jianweizou/dianjian/doc/產品圖片a.jpg

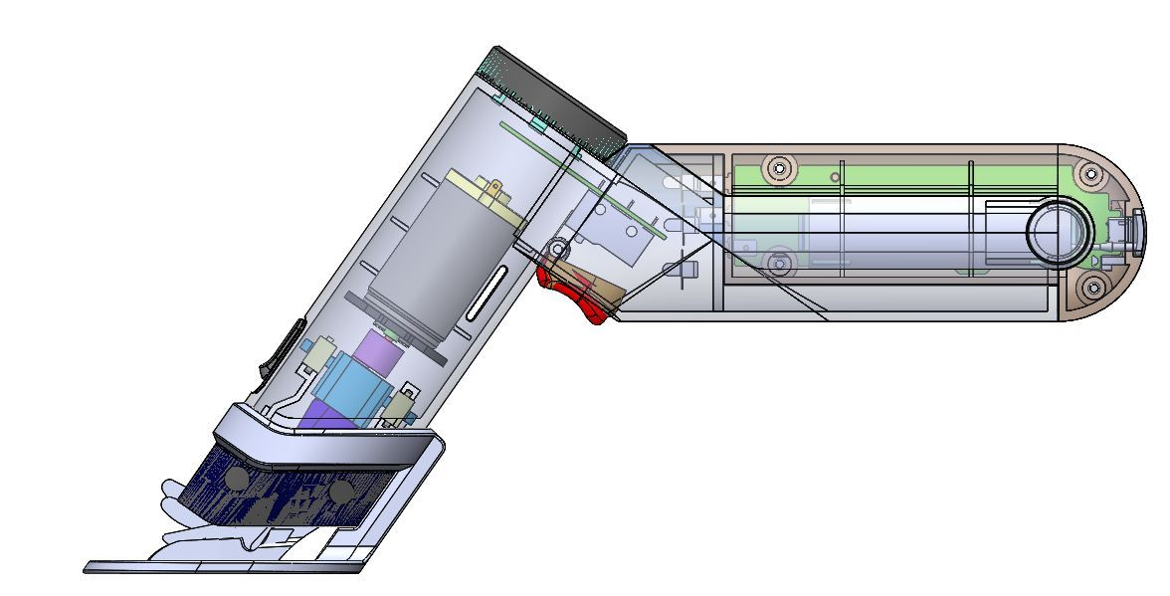
doc/產品圖片a.jpg
