jianweizou/dianjian/doc/產品圖片.jpg

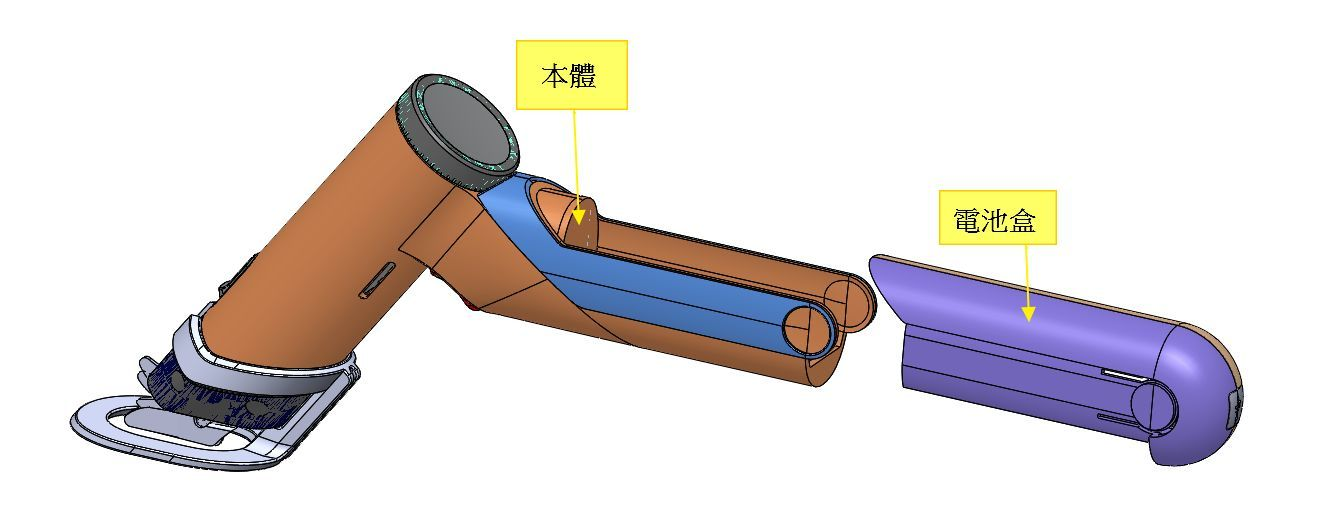
doc/產品圖片.jpg
