jianweizou/dianjian/電剪/產品規格表_Product SPEC20181105 V3.xls

專案系列碼 Project Code |  | 125 | 日期 Date | 2018-11-05 | 版次 Version | V3
專案名稱 Project Name |  | Knives |  |  | 頁次 Page | 1 of 1
機構規格 ME SPEC
項次 No. | 項目 Item |  | 客戶需求 Customer Requirement
1 | Dimensions (LxWxD) |  | mm
2 | Weight |  | g
3 | 外觀處理 |  | TBD
4 | 操作模式
 | 旋鈕 |  | 三段模式 OFF, ON, Auto
 | 按鍵 |  | 當旋鈕切為 ON, 按鍵按下為啟動 當旋鈕切為 Auto 按鍵無功能 當旋鈕切為 OFF 按鍵無功能
5 | 材質 |  | ABS ( 2.5T )
6 | 外觀處理 |  | TBD
7
電氣規格 EE SPEC
項次 No. | 項目 Item |  | 客戶需求 Customer Requirement
1 | Battery |  | 18650 x 1 3.7V 2200mAh 日本電芯
 |  |  | 電池組含充飽斷電 過充保護
2 | Charger |  | 5V Micro USB 電池包直充 無 charging stand
3 | Charging time |  | 30~60mins ( based on 1A 5V adaptor)
4 | Switch
 | 旋鈕 |  | 三段模式 OFF, ON, Auto
 | 按鍵 |  | 當旋鈕切為 ON, 按鍵按下為啟動 當旋鈕切為 Auto 按鍵無功能 當旋鈕切為 OFF 按鍵無功能
5 | Motor |  | Rated Voltage: 3.7VDC Rated Speed: 8,500rpm (min.) Rated Current: 2.0A (max.) Rated Torque: 60g-cm (min.)
5 | Fake Battery |  | no Battery, DC in jack
7 | Fake Battery Adaptor |  | 500mA 4.2V
8
必要規範 Necessary conditions
項次 No. | 項目 Item |  | 客戶需求 Customer Requirement
1 | Cerfitication |  | RoHs, GS, CE
2 | Cutting Range |  | Cotton Fabric
 |  |  | Rubber and Kevlar
 |  |  | Solid Cardboard
 |  |  | Plastic Sheets (PVC)
備註 Note
