jianweizou/dianjian/電剪/pcb板圖.JPG

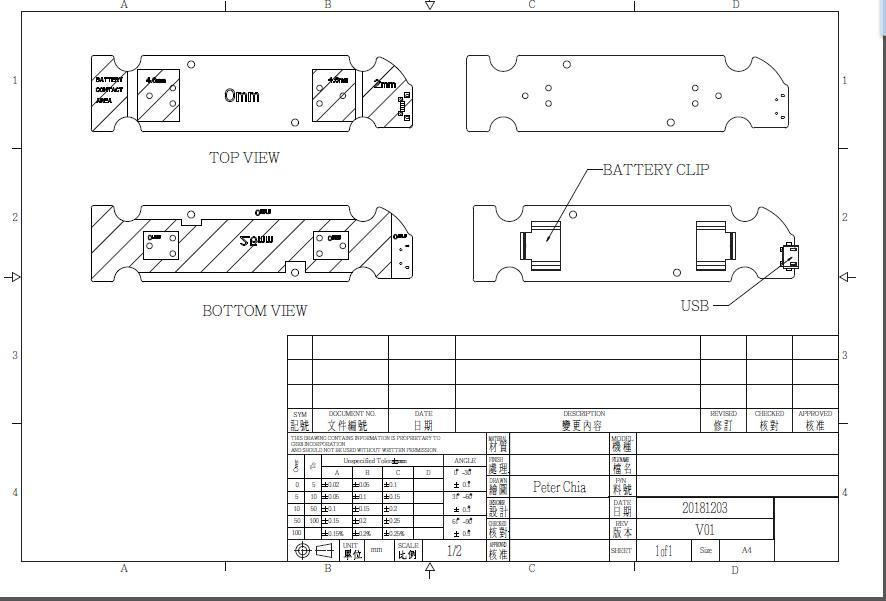
電剪/pcb板圖.JPG
