jianweizou/dianjian/電剪/無電池有線模式產品說明.JPG

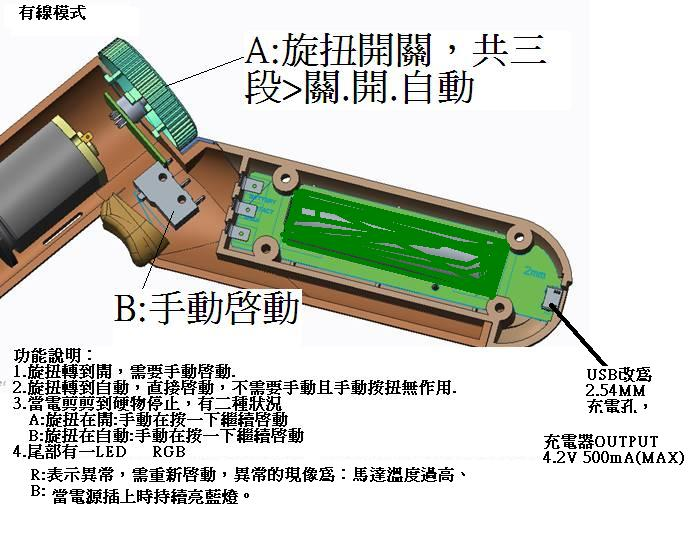
電剪/無電池有線模式產品說明.JPG
