jianweizou/dianjian/電剪/產品示意圖.jpg

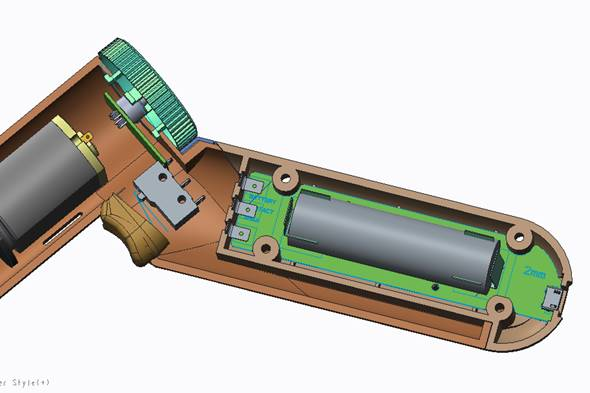
電剪/產品示意圖.jpg
