jianweizou/dianjian/電剪/電池模式產品說明.JPG

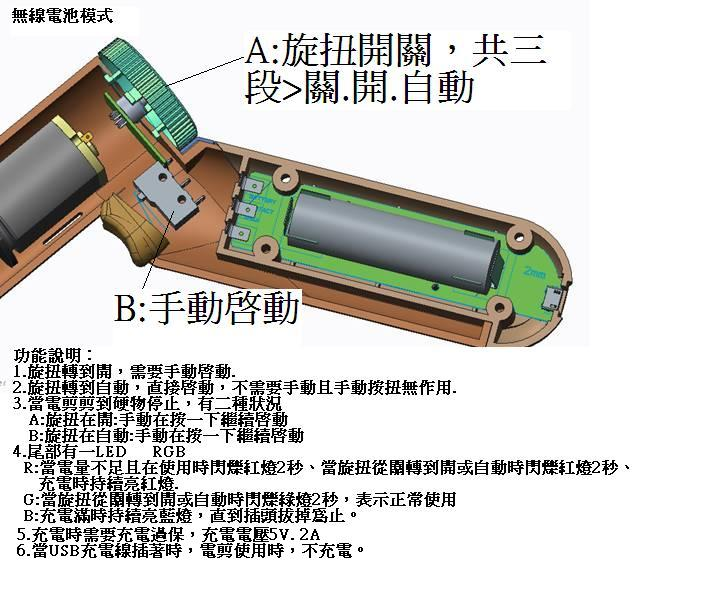
電剪/電池模式產品說明.JPG
