jianweizou/dianjian/电池版本/Layout/电剪_V1.0_20190311/电剪_V1.0.xls

电剪_V1.0
Comment | Designator | Footprint | Quantity | Name
22uF | C1, C4, C8 | C-0805 | 3 | 贴片电容
1uF | C2, C3, C5, C9 | C-0603 | 4
0.1uF | C6 | C-0603 | 1
10uF | C7, C10 | C-0805 | 2
470K | R1 | R-0603 | 1 | 贴片电阻
1M | R2, R3 | R-0603 | 2
4.7K | R4 | R-0603 | 1
1K | R5, R19 | R-0603 | 2
100R | R6 | R-0603 | 1
10K | R7, R9, R10, R16, R20 | R-0603 | 5
0.03R | R8 | R-0805 | 1 |  | https://detail.1688.com/offer/576834509003.html
1.2K | R11 | R-0603 | 1
2K | R12 | R-0603 | 1
330R | R21 | R-0603 | 1
120K | R13 | R-0603 | 1
100K | R14, R15, R17, R18 | R-0603 | 4
LED0 | D1 | LED-0603 | 1 | 贴片LED
18650 | P1 | HDR1X2 | 1 | 2.54mm单排插针180度
TDC-065D | P2 | TDC-065D | 1 | TDC-065D
Header 2 | P3 | HDR1X2 | 1 | 2.54mm单排插针180度
Molex 53398 | P4 | Molex 53398 | 1 | Molex 53398 | 参考链接：https://item.szlcsc.com/264869.html
BM2301 | Q1 | SOT-23 | 1 | MOS(场效应管)
8050 | Q2, Q3 | SOT-23 | 2 | 三极管
DW01 | U1 | SOT-23-6L | 1 | 电池保护IC
PT5110E SOT23 | U2 | SOT-23 | 1 | LDO
8205A | U3 | TSSOP-8 | 1 | IC
TP4056 SOP8 | U4 | ESOP8 | 1 | IC
LM321 | U5 | SOT-23-5 | 1 | IC
N76E003AQ20 | U6 | QFN-20 0.4mm | 1 | IC
