jianweizou/dianjian/doc/Electric Scissor_MB_2D_20190218/main_board_v2.dxf

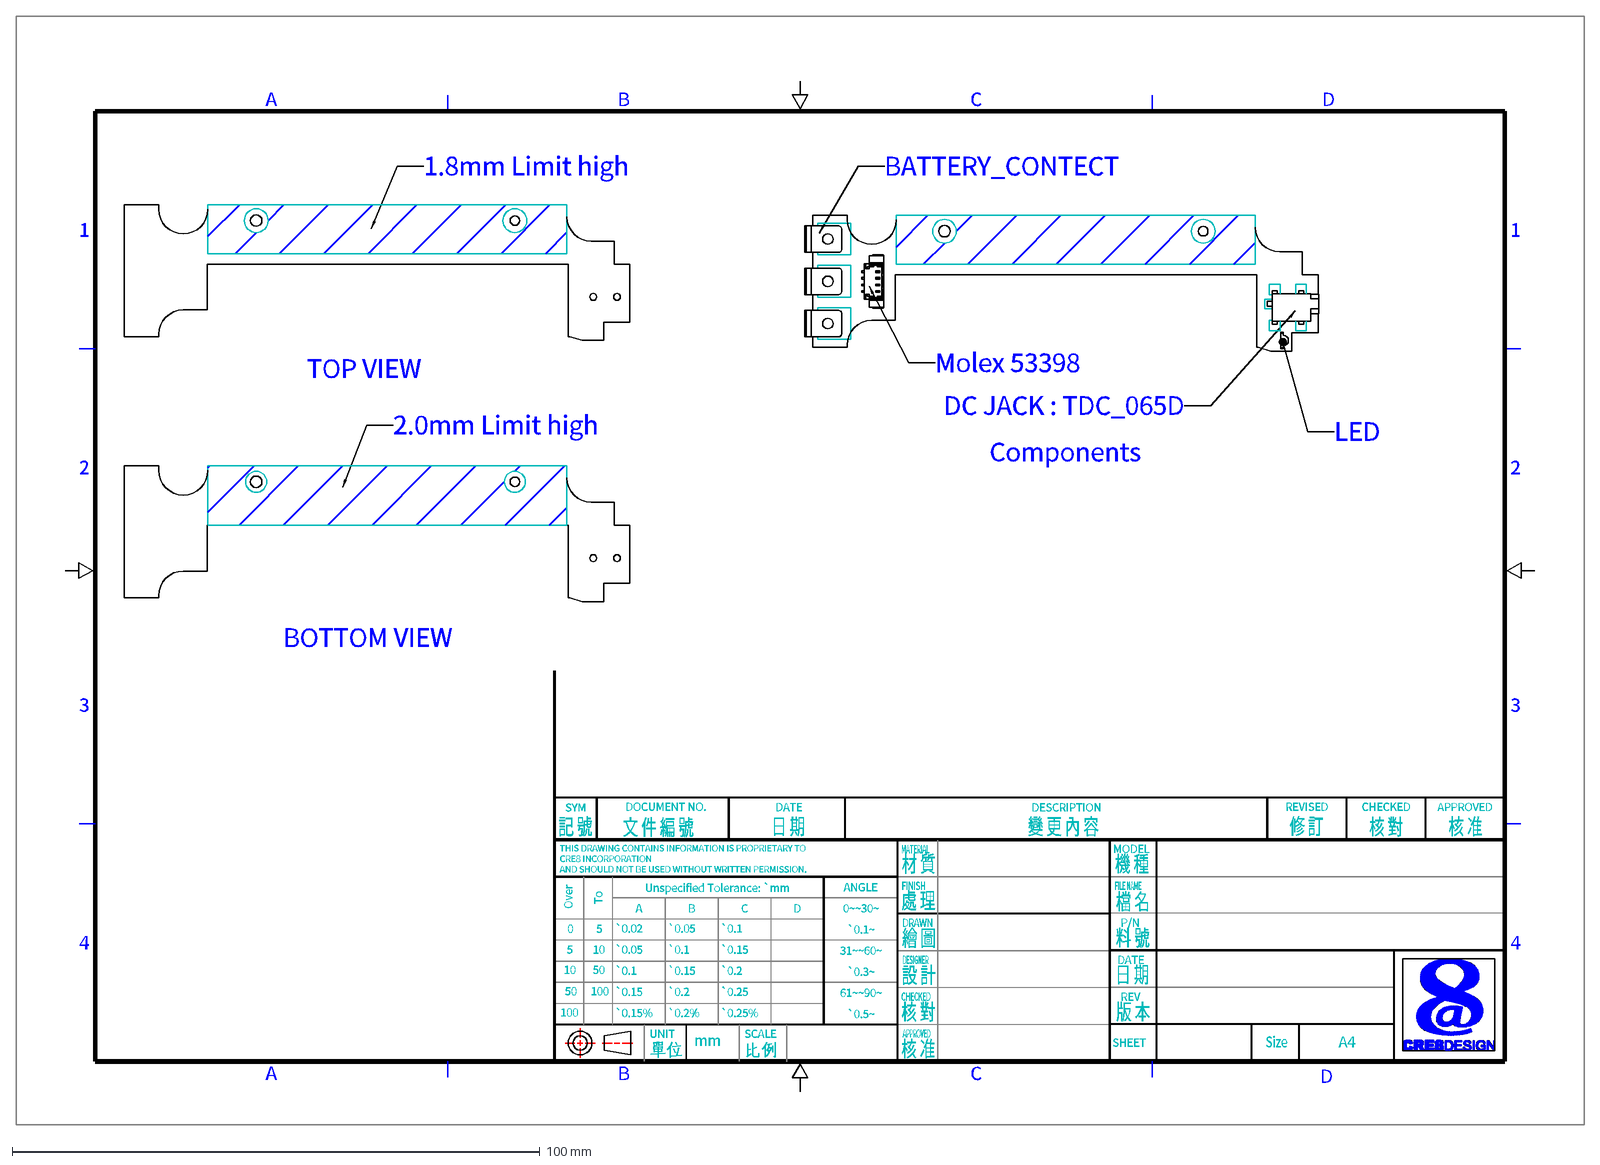
[picture p8: CAD file, 2019-02-26]
doc/Electric Scissor_MB_2D_20190218/main_board_v2.dxf
A
B
C
4
3
CRE8 INCORPORATION
10
SCALE
UNIT
mm
100
50
AND SHOULD NOT BE USED WITHOUT WRITTEN PERMISSION.
0
5
D
ANGLE
THIS DRAWING CONTAINS INFORMATION IS PROPRIETARY TO
2
1
DESCRIPTION
DATE
DOCUMENT NO.
SYM
REVISED
APPROVED
CHECKED
Over
To
A4
DESIGNER
FINISH
DRAWN
MATERIAL
FILE NAME
P/N
MODEL
REV
SHEET
機 種
檔 名
料 號
日 期
版 本
材 質
處 理
設 計
核 准
繪 圖
核 對
Size
記 號
文 件 編 號
變 更 內 容
修 訂
TOP VIEW
BOTTOM VIEW
Components
1.8mm Limit high
2.0mm Limit high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
