jianweizou/dianjian/电池版本/Layout/电剪_V1.0_20190311/电剪_V1.0.DXF

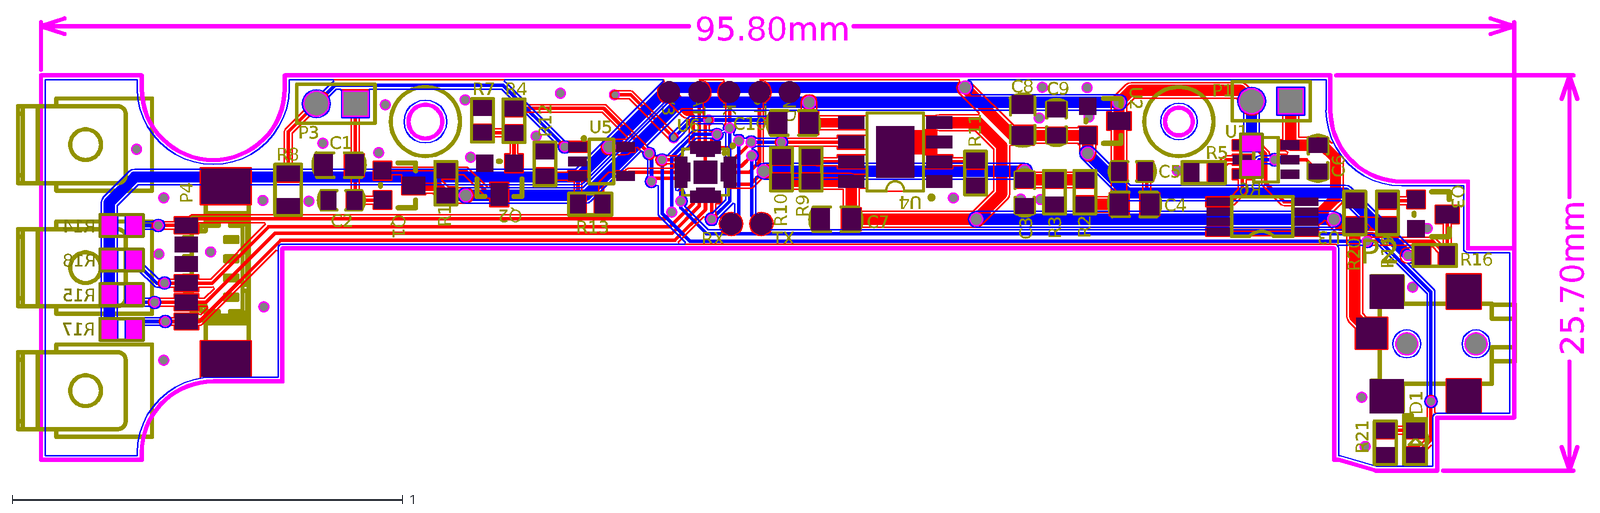
[picture p10: CAD file, 2019-03-12]
电池版本/Layout/电剪_V1.0_20190311/电剪_V1.0.DXF
TX
RX
3V3
DAT
CLK
RST
GND
95.80mm
25.70mm
P2
U6
U5
U4
U3
U2
U1
R21
R20
R19
R18
R17
R16
R15
R14
R13
R12
R11
R10
R9
R8
R7
R6
R5
R4
R3
R2
R1
Q3
Q2
Q1
P4
P3
P1
D1
C10
C9
C8
C7
C6
C5
C4
C3
C2
C1
