jianweizou/dianjian/doc/Electric Scissor_MB_2D_20190218/main_board_v2.pdf

A

1

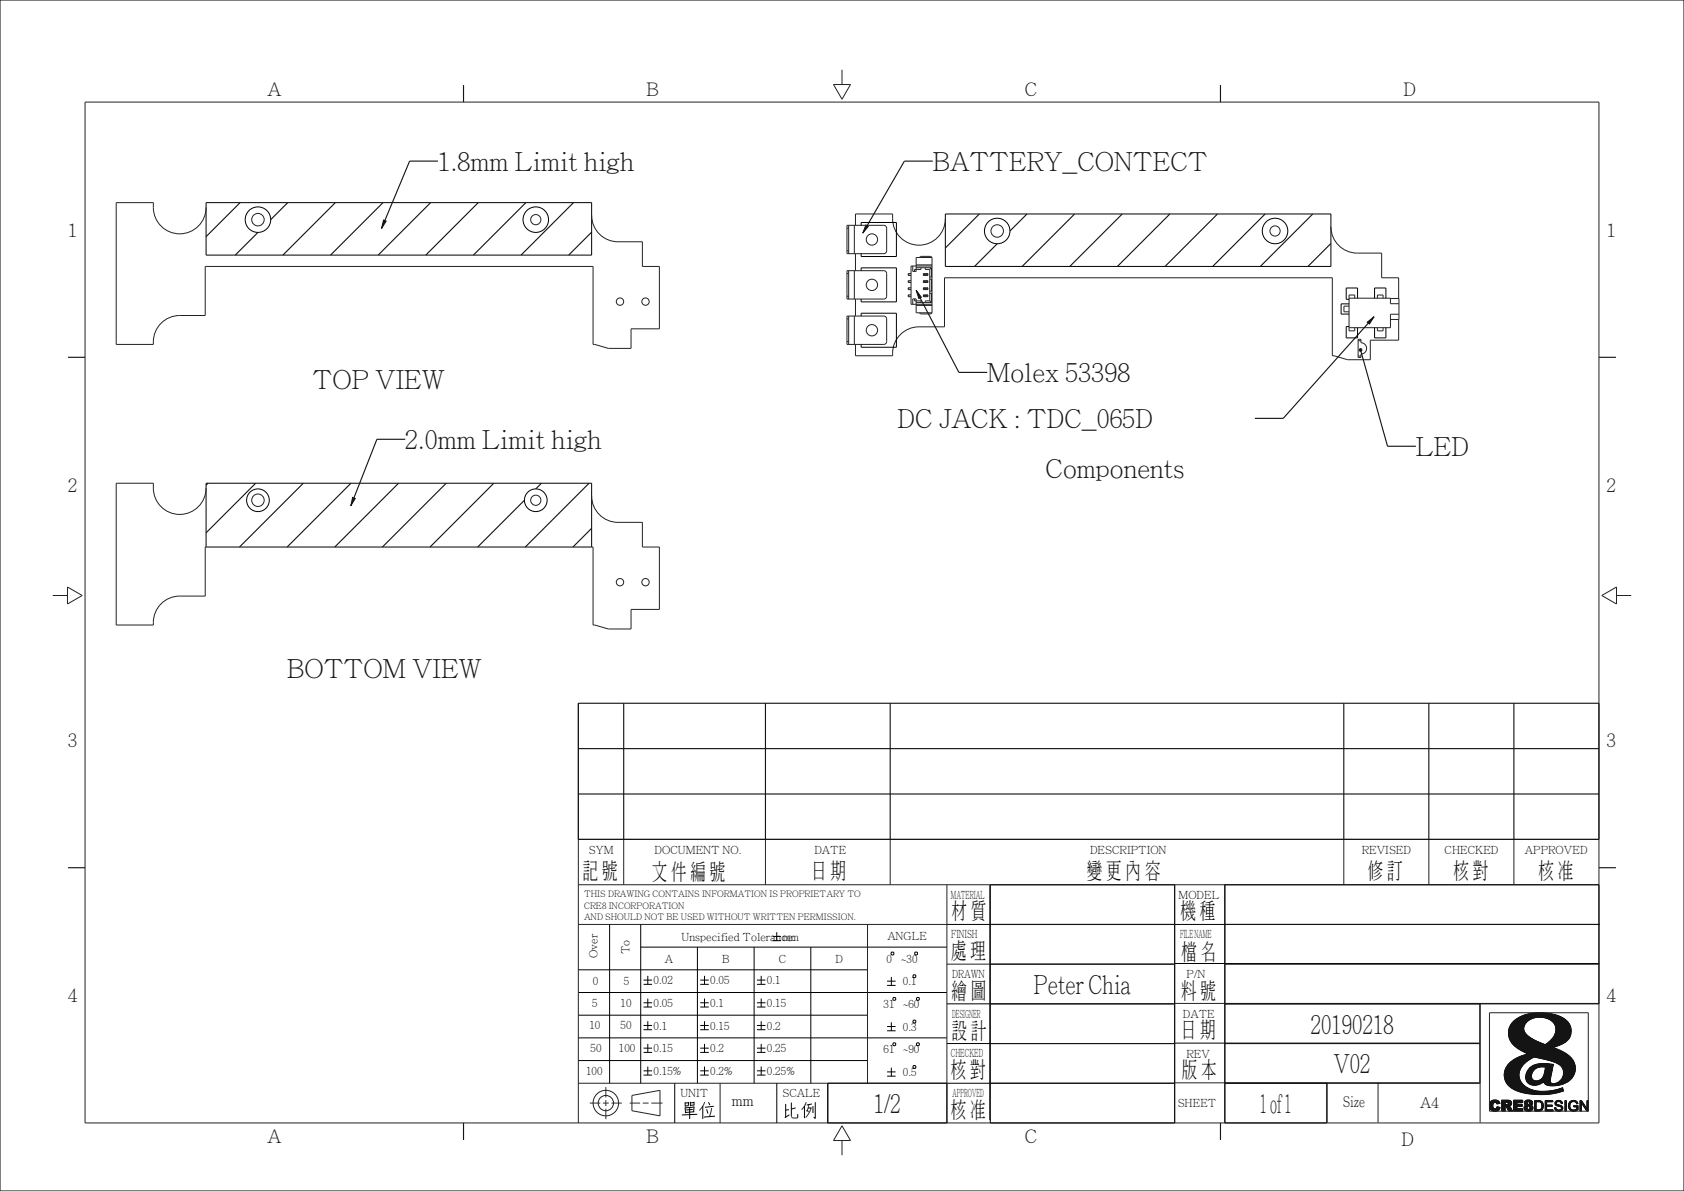
[picture p11: page 1]
Over; TOP VIEW; BOTTOM VIEW; Components; 1.8mm Limit high; 2.0mm Limit high; Molex 53398; BATTERY_CONTECT; DC JACK : TDC_065D; LED

SYM 記 號 | DOCUMENT NO. 文 件 編 號 | DATE 日 期 | DESCRIPTION 變 更 內 容 | REVISED 修 訂 | CHECKED 核 對 | APPROVED 核 准

THIS DRAWING CONTAINS INFORMATION IS PROPRIETARY TO CRE8 INCORPORATION AND SHOULD NOT BE USED WITHOUT WRITTEN PERMISSION. | MATERIAL 材 質 | | MODEL 機 種

Unspecified Tolerance: mm | | ANGLE | FINISH 處 理 | | FILE NAME 檔 名

DRAWN 繪 圖 | Peter Chia | P/N 料 號

DESIGNER 設 計 | | DATE 日 期 | 20190218

50 | 100 | | | | | 61 ~90 | CHECKED 核 對 | | REV 版 本 | V02

UNIT | | SCALE mm | | 1/2 | APPROVED 核 准 | | SHEET | 1 of 1 | Size | A4
