jianweizou/dianjian/doc/5champway_20143523261934179.pdf

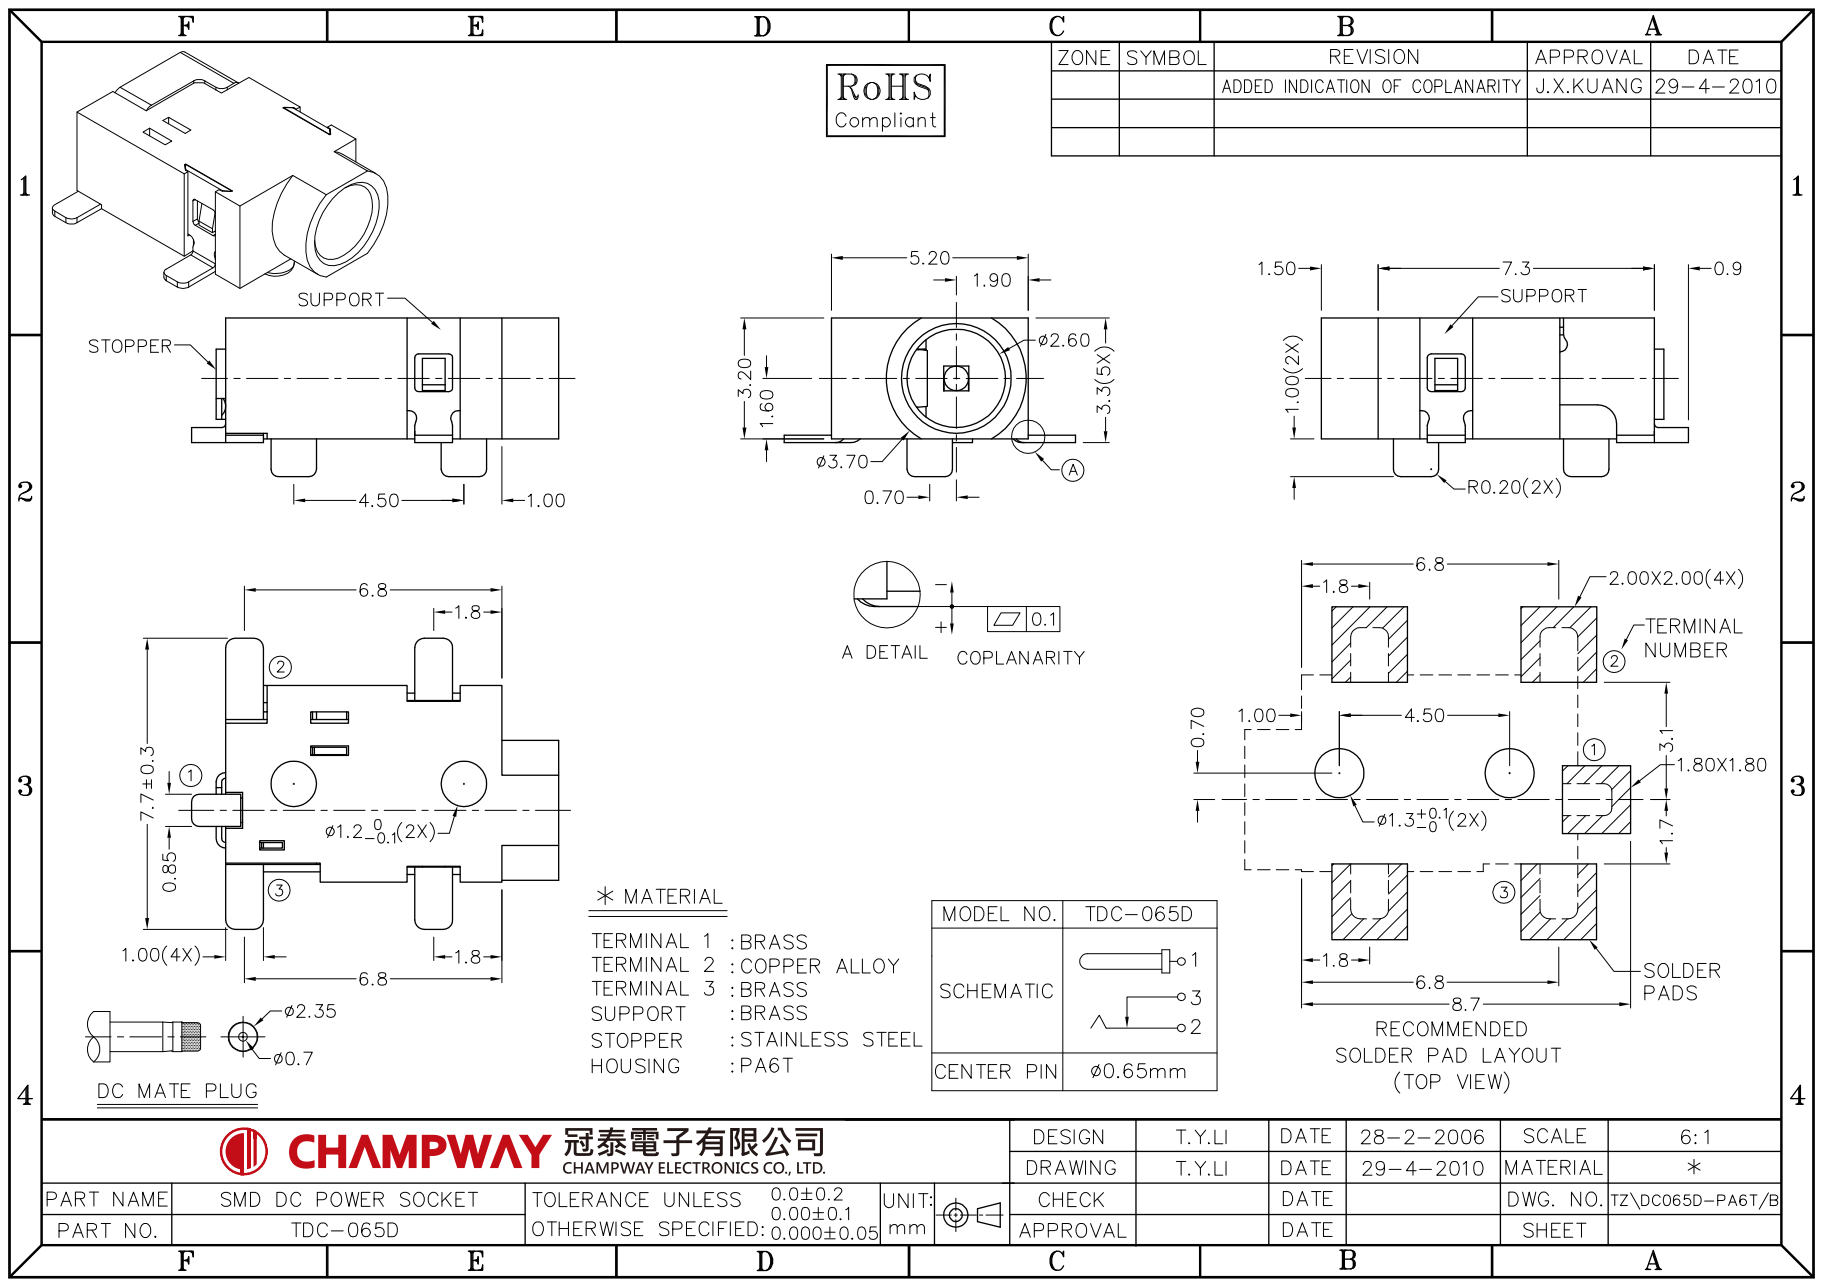
[picture p12: page 1]
