jianweizou/dianjian/(list of files, drawings)

Other design files:
电池版本/Layout/电剪_20181206 V1.0/scissor_20181206_V1.0.PrjPCB
电池版本/Layout/电剪_20181206 V1.0/scissor_20181206_V1.0.SchDoc
电池版本/Layout/电剪_V1.0_20190311/电剪_V1.0.PcbDoc
电池版本/Layout/电剪_V1.0_20190311/电剪_V1.0.SchDoc
