jianweizou/dianjian/(commit log)

2019-02-17 电剪 first commit 20190217
    [main_board_V1.dxf, scissor_20181206_V1.0.PrjPCB, scissor_20181206_V1.0.SchDoc, 產品功能規格表20190118 V5.xlsx, 產品規格表_Product SPEC20181105 V3.xls]
2019-02-25 update sch layout v1.0
    [main_board_V1.dxf, scissor_20181206_V1.0.PrjPCB, scissor_20181206_V1.0.SchDoc]
2019-02-26 update doc
    [main_board_v2.dxf]
2019-03-12 push Layout v1.0
    [电剪_V1.0.DXF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]
